RC360Detector/RC360Detector/system-modeling/state-diagram.pdf

# T08: RC360Detector Software Subsystem (aka state machine diagram, v2)

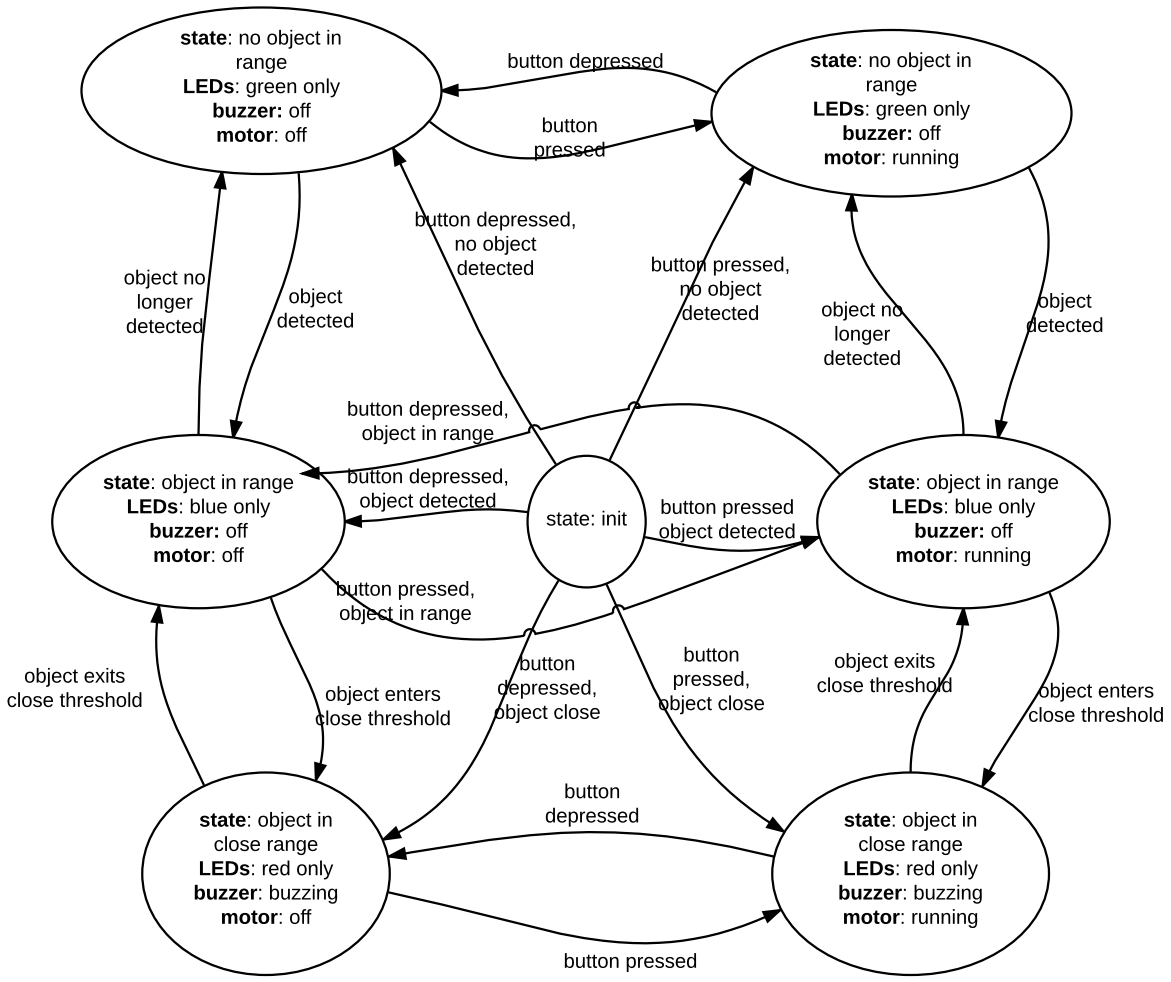
[picture p3: figure]
state: no object in range LEDs: green only buzzer: off motor: running; state: object in range LEDs: blue only buzzer: off motor: running; state: object in close range LEDs: red only buzzer: buzzing motor: running; object exits; close threshold; object enters; state: no object in range LEDs: green only buzzer: off motor: off; state: object in range LEDs: blue only buzzer: off motor: off; state: object in close range LEDs: red only buzzer: buzzing motor: off; object exits close threshold; object enters close threshold; state: init; button depressed, no object detected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

Overview of Functionality and Interface

The control system generates, receives, and responds to the inputs and outputs of the other subsystems. It is implemented as a C program on an Atmega 328P microcontroller.

More detailed information about the inputs and outputs to the control system is in the sensor and motor subsystem documents.

*button active = button down & button presses >= 1
