RC360Detector/RC360Detector/T08-BOM.xls

T08 - Bill of Materials (BOM) for 360 ProxDetector
Qty | Value | Device | Parts | Package | Description | Individual Cost | Total Cost | Cost for 1000 complete units | Store Link
6 | .1u | C-EU0805 | C1, C6, C7, C11, C13, C14 | C0805 | Capacitor | $0.10 | $0.60 | $46.98 | http://www.digikey.com/product-detail/en/1276-1007-1-ND/1276-1007-1-ND/3889093
5 | 240 | R-USR0805 | R2, R3, R4, R6, R14 | R0805 | Resistor | $0.12 | $0.60 | $110.34 | http://www.digikey.com/product-detail/en/ERJ-P06J241V/P240ADCT-ND/525482
5 | 10u | C-EU0805 | C3, C8, C9, C10 | C0805 | Capacitor | $0.20 | $1.00 | $198.00 | http://www.digikey.com/product-detail/en/490-5523-1-ND/490-5523-1-ND/2334919
4 | 0 | R-USR0805 | R10, R11, R12, R13 | R0805 | Resistor | $0.29 | $1.16 | $145.20 | http://www.digikey.com/product-detail/en/CRCW08050000Z0EAHP/541-0.0TBCT-ND/2222831
4 | 4.7k | R-USR0805 | R8, R9, R16, R17 | R0805 | Resistor | $0.10 | $0.40 | $46.75 | http://www.digikey.com/product-detail/en/RHM4.7KKCT-ND/RHM4.7KKCT-ND/1763028
3 | 1u | C-EU0805 | C4, C5, C12 | C0805 | Capacitor | $0.11 | $0.33 | $33.75 | http://www.digikey.com/product-detail/en/1276-1066-1-ND/1276-1066-1-ND/3889152
3 |  |  | SV1, X4, X5, X1, X3, X6 |  | .1” Breakaway Header 1x18 | $0.33 | $0.99 | $411.80 | http://www.digikey.com/product-detail/en/PREC018SAAN-RC/S1012EC-18-ND/2774836
2 | 10k | R-USR0805 | R1, R7 | R0805 | Resistor | $0.12 | $0.24 | $36.78 | http://www.digikey.com/product-detail/en/ERJ-P06J103V/P10KADCT-ND/525438
2 |  | LM317M | IC1, IC2 | SOT223 | Adjustable Voltage Regulator | $0.85 | $1.70 | $726.00 | http://www.digikey.com/product-detail/en/296-12631-1-ND/296-12631-1-ND/454186
2 |  |  |  |  | 9V Alkaline Battery | $2.38 | $4.76 | $1316.70 | http://www.digikey.com/product-detail/en/EN22/N145-ND/704825
2 |  |  |  |  | Machine SCR x8 #6-32x3/4” Pack | $1.18 | $2.36 | $1475.00
1 |  |  |  |  | 40 Fem-Fem x20cm Jumper Wires | $4.45 | $4.45 | $1057.50 | http://www.mouser.com/ProductDetail/BusBoard-Prototype-Systems/ZW-FF-20/?qs=I13xAFqYpRQREEVptt0EZQ%3D%3D
1 |  |  |  |  | 4.7x4.7x3.5" Black ABS Enclosure | $7.25 | $7.25 | $4910.00 | http://www.mouser.com/ProductDetail/Hammond-Manufacturing/1591VSBK/?qs=N74Wby3oBT%252bxNwB4Op%2FT9Q%3D%3D
1 |  | PCA9306_Breakout | PCA9306 |  | Level Translator Breakout - PCA9306 | $6.95 | $6.95 | $5910.00 | https://www.sparkfun.com/products/11955
1 |  |  | JP1 |  | Shunt Jumper .1” | $0.10 | $0.10 | $42.00 | http://www.digikey.com/product-detail/en/969102-0000-DA/3M9580-ND/2071621
1 | 1.1k | R-USR0805 | R15 | R0805 | Resistor | $0.16 | $0.16 | $21.78 | http://www.digikey.com/product-detail/en/ESR10EZPF1101/RHM1.10KAECT-ND/1983808
1 | 715 | R-USR0805 | R5 | R0805 | Resistor | $0.76 | $0.76 | $195.44 | http://www.digikey.com/product-detail/en/2176092-5/A110529CT-ND/4034884
1 |  | Atmega328P | U2 | DIL28-3 | Microcontroller | $3.70 | $3.70 | $1850.94 | http://www.digikey.com/product-detail/en/ATMEGA328P-PU/ATMEGA328P-PU-ND/1914589
1 |  |  | LED7 |  | Blue LED 5mm T/H | $0.21 | $0.21 | $162.00 | http://www.digikey.com/product-detail/en/C503B-BCN-CV0Z0461/C503B-BCN-CV0Z0461-ND/1922945
1 |  |  | LED5 |  | Red LED 5mm T/H | $0.15 | $0.15 | $115.00 | http://www.digikey.com/product-detail/en/C503B-RCN-CW0Z0AA1/C503B-RCN-CW0Z0AA1-ND/1922930
1 |  |  | LED6 |  | Green LED 5mm T/H | $0.30 | $0.30 | $53.51 | http://www.digikey.com/product-detail/en/LTL2R3KGD-EM/160-1852-ND/2675131
1 |  | CX-0905C | CX-0905C | CX-0905C | 5V DC Buzzer | $2.47 | $2.47 | $1100.55 | http://www.digikey.com/product-detail/en/CX-0905C/102-1285-ND/671241
1 |  | LM1117 | IC3 | SOT-223 |  | $0.46 | $0.46 | $142.45 | http://www.digikey.com/product-detail/en/LD1117S33TR/497-1242-1-ND/586242
1 |  |  |  |  | LCD DISPLAY RGB LED BKLT 20 X 2 | $12.00 | $12.00 | $8875.00 | http://www.digikey.com/product-detail/en/NHD-C0220BIZ-FS(RGB)-FBW-3VM/NHD-C0220BIZ-FS(RGB)-FBW-3VM-ND/3507740
1 |  |  |  |  | DPST Rocker Switch | $1.23 | $1.23 | $784.00 | http://www.digikey.com/product-detail/en/LRA32H2FBBNN/CH770-ND/446036
1 |  |  | Sensor |  | Distance Measuring Sensor Unit | $9.95 | $9.95 | $6950.00 | https://www.pololu.com/product/136
1 |  |  |  |  | 3/4 in. x 5 ft. Black Indoor Fasteners | $6.97 | $6.97 | $232.34 | http://www.homedepot.com/p/Scotch-3-4-in-x-5-ft-Black-Indoor-Fasteners-RF4741/204465386
1 |  |  |  |  | High Speed Continuous Rotation Servo | $16.99 | $16.99 | $16990.00 | https://www.parallax.com/product/900-00025
1 |  |  |  |  | SWITCH PUSHBUTTON SPST | $1.80 | $1.80 | $1278.40 | http://www.digikey.com/product-detail/en/PR141C1000-116/EG4698-ND/2116177
1 |  |  |  |  | x30 #6 Washer | $1.18 | $1.18 | $40.00
1 |  |  |  |  | x100 #6-32 machine screw Nut | $3.82 | $3.82 | $99.32
2 |  |  |  |  | 9V Battery clip 4”LD | $0.58 | $1.16 | $493.00 | http://www.digikey.com/scripts/DkSearch/dksus.dll?Detail&itemSeq=185591659&uq=635852822527885107
 |  |  |  |  |  | Total: | $95.04 | $55357.53
