RC360Detector/RC360Detector/system-modeling/physical-view.pdf

T08:

## RC360detector

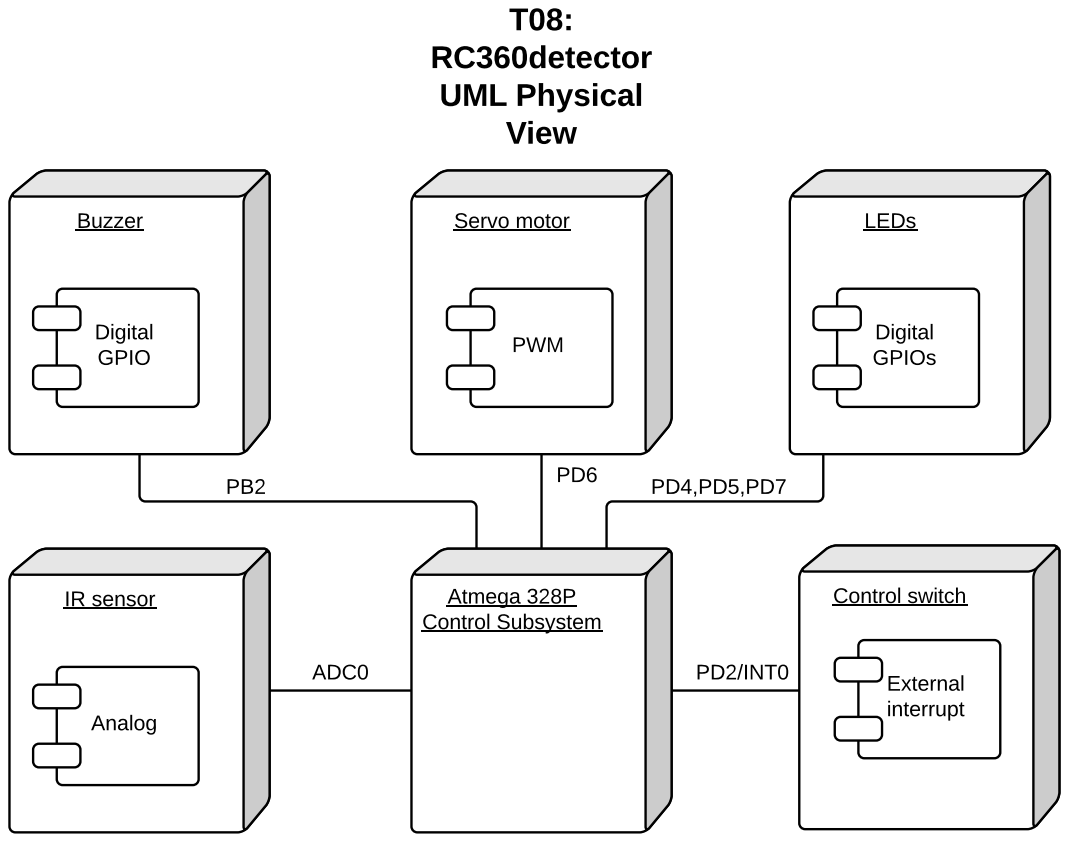
[picture p6: page 1]
LEDs; IR sensor; Control switch; Buzzer; Servo motor; Digital GPIO; External interrupt Analog; Digital GPIOs PWM; UML Physical View; Atmega 328P Control Subsystem; PD2/INT0; ADC0
