RC360Detector/RC360Detector/system-modeling/level-1.pdf

## T08: RC360Detector Level 1 Block Diagram

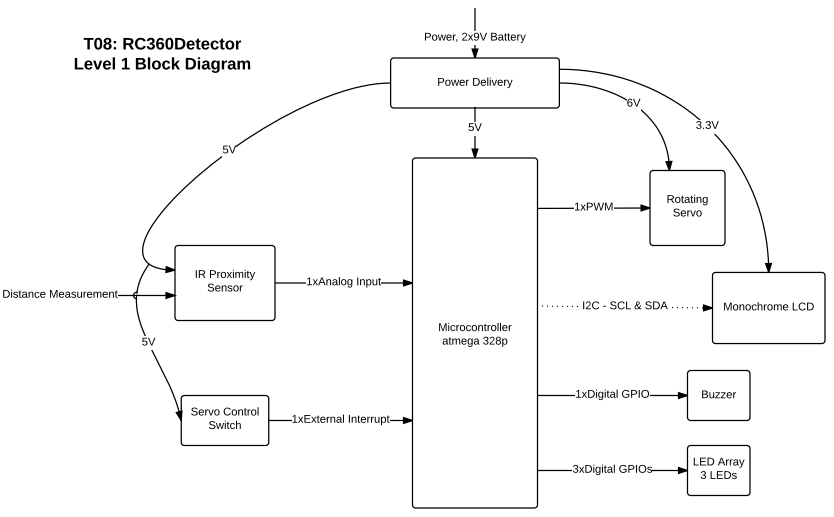
[picture p7: page 1]
Microcontroller atmega 328p; Power Delivery; Power, 2x9V Battery; I2C - SCL & SDA; Monochrome LCD; 1xAnalog Input; IR Proximity Sensor; Distance Measurement; 1xDigital GPIO; Buzzer; Servo Control Switch; 1xExternal Interrupt; 3xDigital GPIOs; LED Array 3 LEDs; 1xPWM; Rotating Servo
