RC360Detector/RC360Detector/system-modeling/level-zero-block-diagram.pdf

## T08: RC360 Detector Level 0 Block Diagram

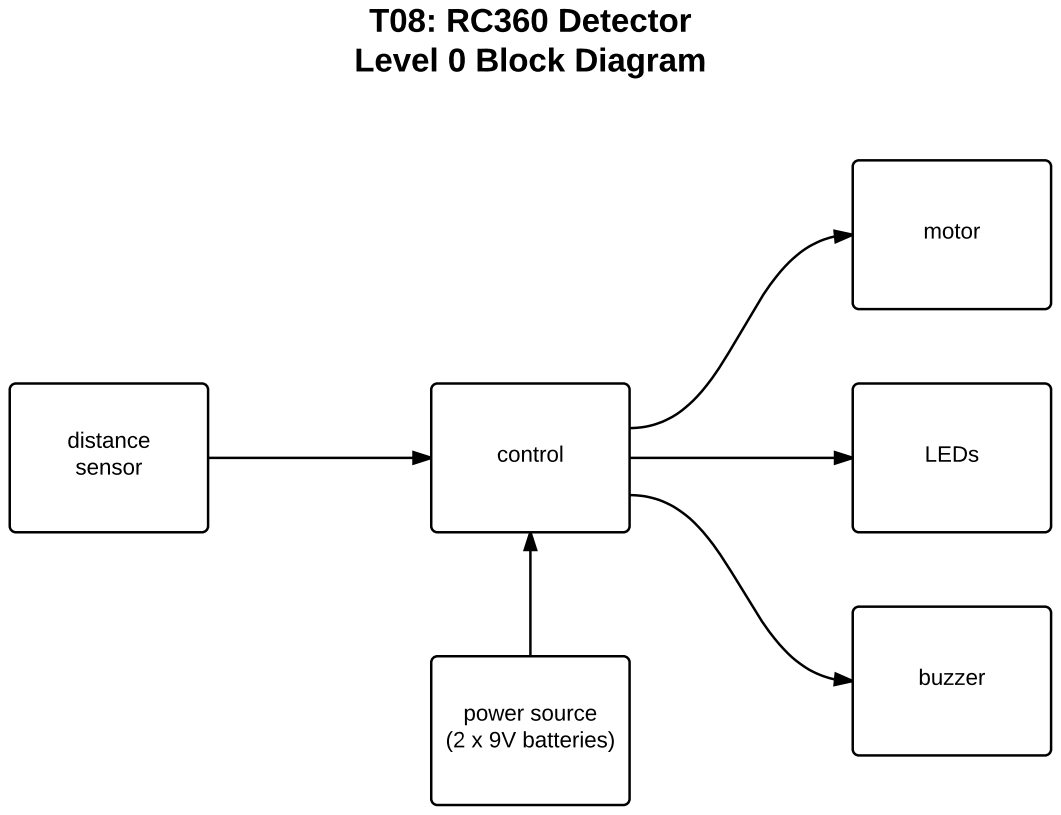
[picture p8: page 1]
distance sensor; control; LEDs; motor; buzzer; power source (2 x 9V batteries)
