RC360Detector/RC360Detector/system-modeling/power-subsystem.pdf

T08:

## RC360Detector

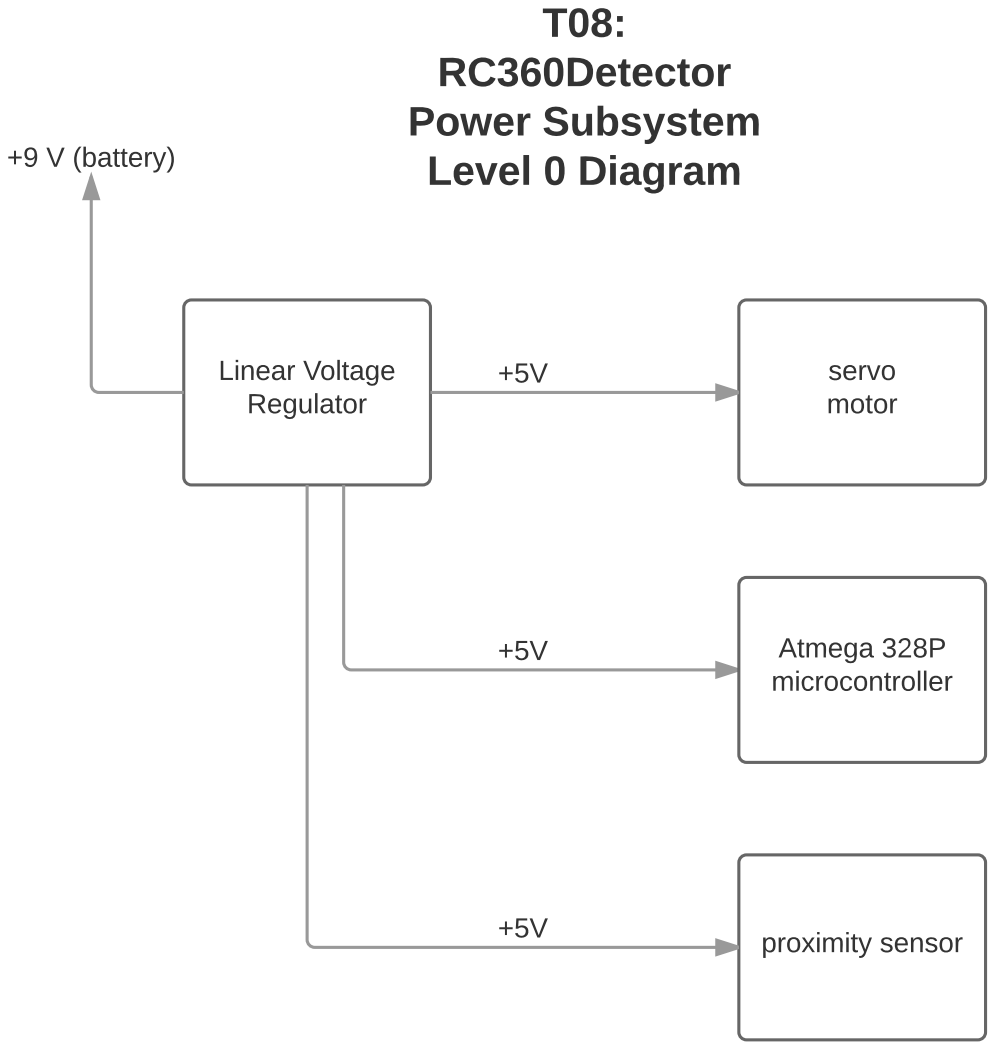
[picture p9: page 1]
Power Subsystem Level 0 Diagram; servo motor; +9 V (battery); Atmega 328P microcontroller; proximity sensor

Linear Voltage Regulator
