RC360Detector/RC360Detector/T08_rc360detector_final.brd

## EAGLE design T08_rc360detector_final.brd (2015-11-11)

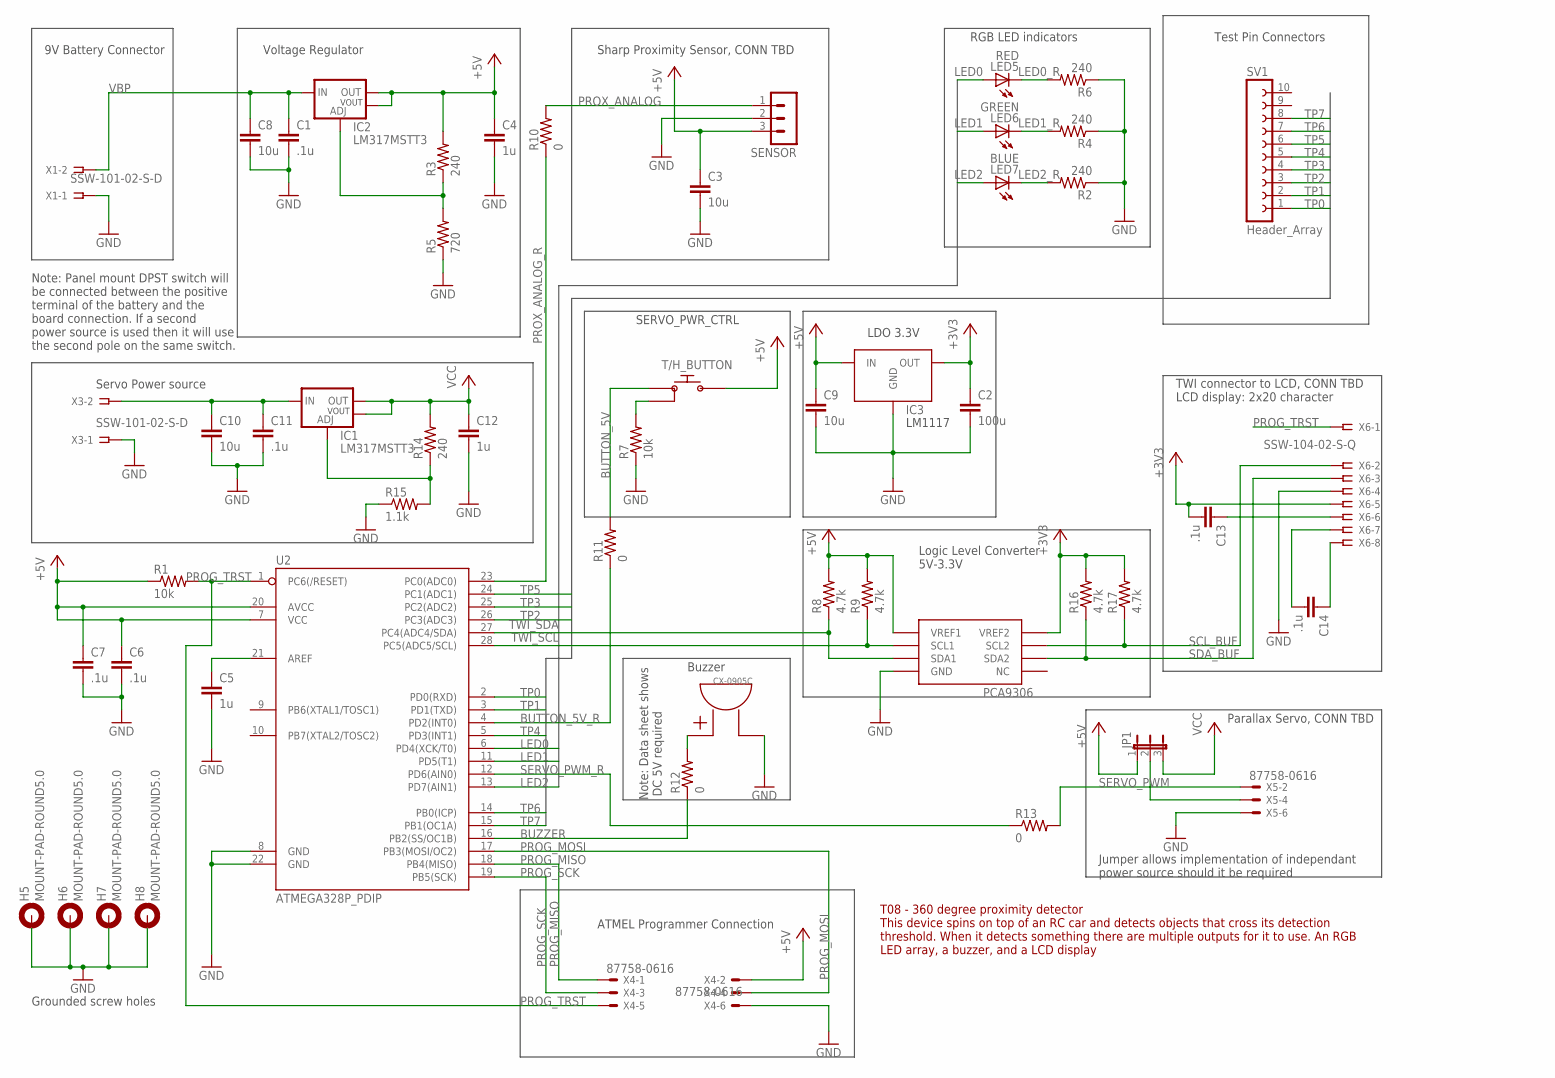
[picture p10: schematic T08_rc360detector_final.sch]

Parts:
C1, C6, C7, C11, C13, C14: .1u; C0805
C2: 100u; C0805
C3, C8, C9, C10: 10u; C0805
C4, C5, C12: 1u; C0805
CX-0905C: CX-0905C; BUZZER_CX-0905C
H5, H6, H7, H8: MOUNT-PAD-ROUND5.0; 5,0-PAD
IC1, IC2: LM317MSTT3; SOT223
IC3: LM1117; SOT-223
JP1: JP2E; JP2
LED5: RED; LD260
LED6: GREEN; LD260
LED7: BLUE; LD260
PCA9306: PCA9306_BREAKOUT
R1, R7: 10k; R0805
R2, R3, R4, R6, R14: 240; R0805
R5: 720; R0805
R8, R9, R16, R17: 4.7k; R0805
R10, R11, R12, R13: 0; R0805
R15: 1.1k; R0805
SENSOR: MA03-1
SV1: Header_Array; FE10
T/H_BUTTON: PR141C; 3_THROUGH_HOLE
U2: ATMEGA328P_PDIP; DIL28-3
X1, X3: SSW-101-02-S-D
X4, X5: 87758-0616
X6: SSW-104-02-S-Q

Connections:
+3V3: C2.1, C13.2, IC3.VOUT (OUT), PCA9306.VREF2, R16.2, R17.2, X6.5
+5V: C3.1, C4.1, C6.1, C7.1, C9.1, IC2.2 (VOUT), IC2.4 (OUT), IC3.IN, JP1.1, PCA9306.VREF1, R1.1, R3.2, R8.2, R9.2, SENSOR.3, T/H_BUTTON.P$3 (OUT), U2.7 (VCC), U2.20 (AVCC), X4.2
AREF: C5.1, U2.21 (AREF)
BUTTON_5V: R11.2, T/H_BUTTON.P$1 (IN)
BUTTON_5V_R: R11.1, U2.4 (PD2(INT0))
BUZZER: R12.1, U2.16 (PB2(SS/OC1B))
GND: C1.2, C2.2, C3.2, C4.2, C5.2, C6.2, C7.2, C8.2, C9.2, C10.2, C11.2, C12.2, CX-0905C.OUT, H5.B5, H6.B5, H7.B5, H8.B5, IC3.GND, PCA9306.GND, R2.1, R4.1, R5.1, R6.1, R7.1, R15.1, SENSOR.2, U2.8 (GND), U2.22 (GND), X1.1, X3.1, X4.6, X5.6, X6.4
LED0: LED5.A, U2.6 (PD4(XCK/T0))
LED0_R: LED5.K (C), R6.2
LED1: LED6.A, U2.11 (PD5(T1))
LED1_R: LED6.K (C), R4.2
LED2: LED7.A, U2.13 (PD7(AIN1))
LED2_R: LED7.K (C), R2.2
unnamed: R7.2, T/H_BUTTON.P$2 (GND)
unnamed: IC2.1 (ADJ), R3.1, R5.2
unnamed: CX-0905C.IN, R12.2
unnamed: IC1.1 (ADJ), R14.1, R15.2
unnamed: C10.1, C11.1, IC1.3 (IN), X3.2
unnamed: JP1.2, X5.4
unnamed: C13.1, X6.6
unnamed: C14.2, X6.7
unnamed: C14.1, X6.8
PROG_MISO: U2.18 (PB4(MISO)), X4.1
PROG_MOSI: U2.17 (PB3(MOSI/OC2)), X4.4
PROG_SCK: U2.19 (PB5(SCK)), X4.3
PROG_TRST: R1.2, U2.1 (PC6(/RESET)), X4.5, X6.1
PROX_ANALOG: R10.2, SENSOR.1
PROX_ANALOG_R: R10.1, U2.23 (PC0(ADC0))
SCL_BUF: PCA9306.SCL2, R17.1, X6.2
SDA_BUF: PCA9306.SDA2, R16.1, X6.3
SERVO_PWM: R13.2, X5.2
SERVO_PWM_R: R13.1, U2.12 (PD6(AIN0))
TP0: SV1.1, U2.2 (PD0(RXD))
TP1: SV1.2, U2.3 (PD1(TXD))
TP2: SV1.3, U2.26 (PC3(ADC3))
TP3: SV1.4, U2.25 (PC2(ADC2))
TP4: SV1.5, U2.5 (PD3(INT1))
TP5: SV1.6, U2.24 (PC1(ADC1))
TP6: SV1.7, U2.14 (PB0(ICP))
TP7: SV1.8, U2.15 (PB1(OC1A))
TWI_SCL: PCA9306.SCL1, R9.1, U2.28 (PC5(ADC5/SCL))
TWI_SDA: PCA9306.SDA1, R8.1, U2.27 (PC4(ADC4/SDA))
VBP: C1.1, C8.1, IC2.3 (IN), X1.2
VCC: C12.1, IC1.2 (VOUT), IC1.4 (OUT), JP1.3, R14.2

Notes on the sheet:
9V Battery Connector
Voltage Regulator
Sharp Proximity Sensor, CONN TBD
Parallax Servo, CONN TBD
ATMEL Programmer Connection
TWI connector to LCD, CONN TBD LCD display: 2x20 character
RGB LED indicators
Test Pin Connectors
SERVO_PWR_CTRL
Buzzer
T08 - 360 degree proximity detector This device spins on top of an RC car and detects objects that cross its detection threshold. When it detects something there are multiple outputs for it to use. An RGB LED array, a buzzer, and a LCD display
Note: Data sheet shows DC 5V required
Note: Panel mount DPST switch will be connected between the positive terminal of the battery and the board connection. If a second power source is used then it will use the second pole on the same switch.
Jumper allows implementation of independant power source should it be required
Servo Power source
LDO 3.3V
Logic Level Converter 5V-3.3V
Grounded screw holes

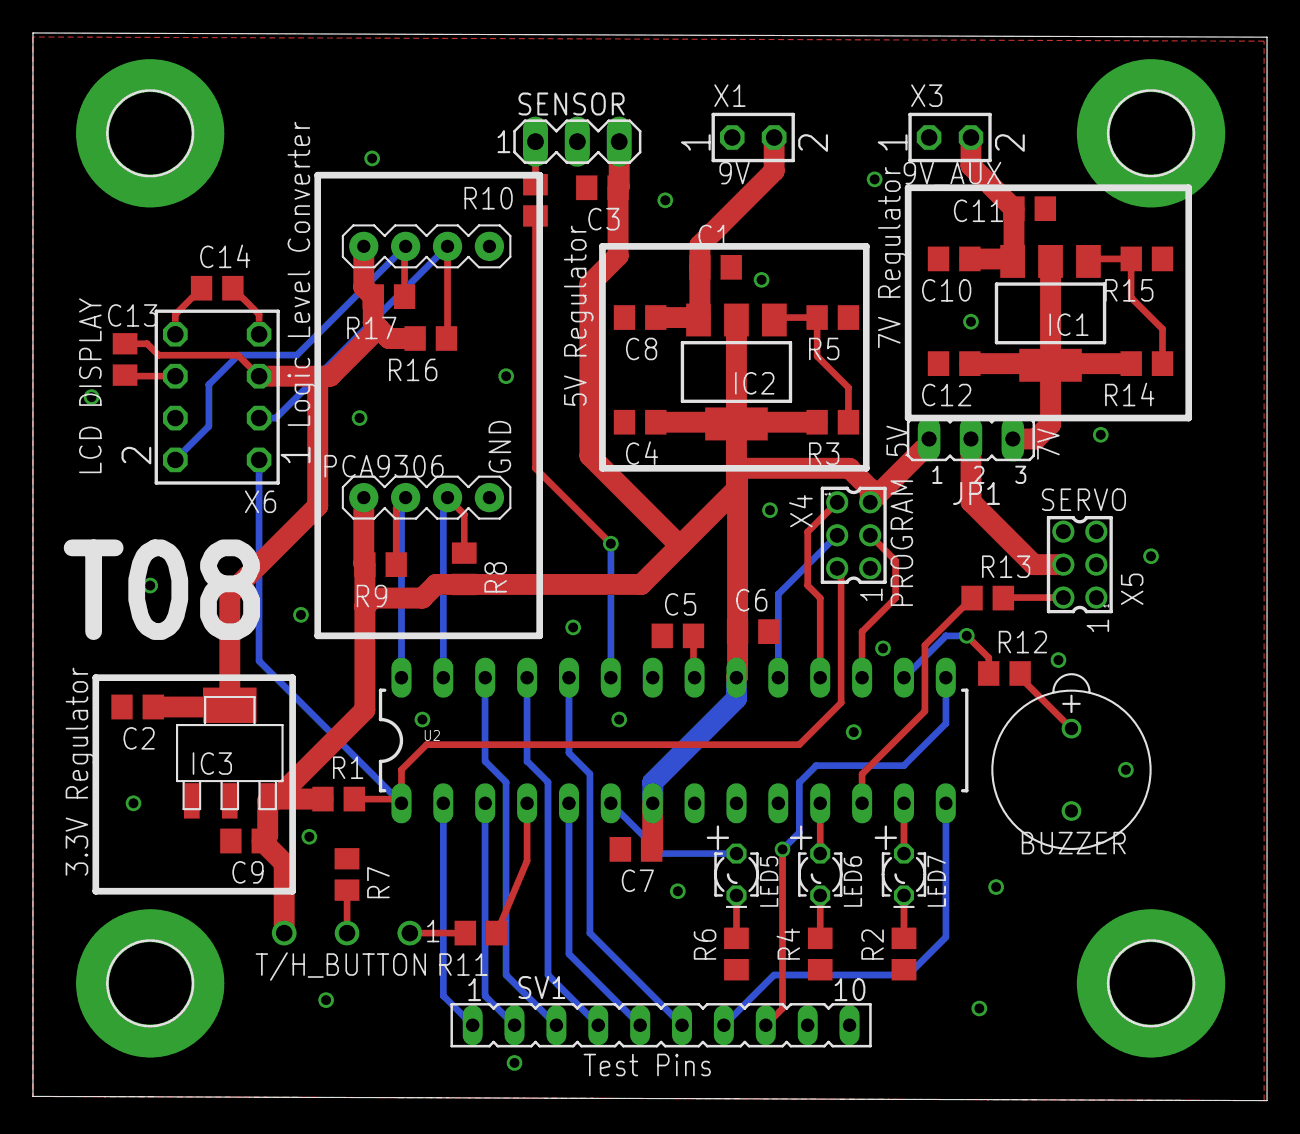
[picture p11: board T08_rc360detector_final.brd from above]

Board: 2 copper layers, 74.9 x 64.8 mm, 53 parts (0 on the bottom side), 44 nets.
