RC360Detector/RC360Detector/(commit log)

2015-10-25 Adding c program for blinking LED to the repo.
2015-10-28 Schematic
    -Added frame and info boxes
    -changed layer of text to 'info'
    -changed symbols of resistors and caps to American and European,
    respectively
    -combined caps that where in parallel
    [rc360detector_102815.sch]
2015-10-30 Update
    -Added RGB LEDs
    -Reorganized layout
    -Added TWI (aka I2C) interface connections
    -Added Test points to critical signals
    [rc360detector_102815.sch]
2015-10-31 Code works with proximity sensor.
2015-10-31 Got motor working
2015-11-01 Dif file
    Added bus to LED lines
    Added Test Points to unused uC pins
    Added Buzzer circuit
    Added Button circuit
    Added switch between battery and volt reg
    Moved reset jumper
    Changed IR sensor connection to surface pads
    [rc360detector.sch]
2015-11-02 New file that contains proper file name
    changed power caps
    aqdded vcc caps
    added pull ups on TWI lines
    changed aref cap value
    labeled micro controller
    removed jumpers
    connected programming lines to jumpers
    removed dipswitch on power, need better solution
    added notes to needed changes on schematic
    added basic description
    [T08_rc360detector.sch]
2015-11-03 First pass at board layout
    Started board layout. The problems:
    -The current atmega328 block is way too small for us to solder, changed
    to the pdip for the moment
    -not sure if I got the rules check file working
    -PCB layers are at 16, and it should be 2
    -Need mounting screws tied to ground added to sch
    -Added second power supply for servo
    -Need to change layout to buzzer I found. Dimensions in components wiki
    [T08_rc360detector.brd, T08_rc360detector.sch]
2015-11-04 2nd pass
    -Added custom library that contains button and buzzer
    -Routed rest of connections. Left TWI interface out until Jared adds the
    finished connections to the schematic
    -Added screw holes, can resize if we want bigger screws
    -Added some basic silk screen
    -Added jumper for servo so we can switch it between if needed.
    -Still need to find actual LEDs, until then there are generic T/H
    -Havnt touched DRC, must look into in future
    [T08_rc360detector.brd, T08_rc360detector.sch]
2015-11-05 Added LM1117
    Added LDO voltage regulator LM1117 w/ SOT-223 layout
2015-11-06 Update
    Rerouted layout with new TWI circuitry. The logic converter IC is so
    small the chip doesnt pass DRC, so I informed Jared and he's looking
    into an alternate solution. Also the current chip is PDIP but I'm
    debating changing it to TQFP. Will need to discuss tomorrow.
    [T08_rc360detector.brd, T08_rc360detector.sch]
2015-11-07 Added interrupt code.
2015-11-07 Got pwm enable working on interrupt.
2015-11-07 Adding 3 LED code, in progress.
2015-11-09 Finished preliminary layout
    Finished layout after feedback today
    Also made an alternate layout that I feel is cleaner and experimented
    with importing silkscreen images.
    [T08_rc360detector_alt.brd, T08_rc360detector_alt.sch, rc360detector_102815.sch]
2015-11-09 Slight changes. Passed DRC
    Made sure DRC worked and had updated libraries. This should work now,
    (hopefully)
    [T08_rc360detector.brd, T08_rc360detector.sch, T08_rc360detector_alt.brd, T08_rc360detector_alt.sch]
2015-11-11 Supposedly last submission of board
    -Changed LM1117 caps to higher values as per datasheet
    -compacted layout to take up less space
    -Changed to larger diameter mounting holes
    -Connected floating vout pin on lm317s to other vout
    -Changed jumper to format that uses header pins
    [T08_rc360detector_final.brd, T08_rc360detector_final.sch]
2015-11-14 Adding in Jared's 3-LED code.
2015-11-18 Adding sensor subsystem.
2015-11-23 Fixed typo on motor testplan.
2015-12-05 Presentation Power Point
    First pass at relevant topics
2015-12-10 BOM for 360 detector project
    [T08-BOM.xls]
2015-12-10 adding revised motor test plan
